vitormiran/flightscope-public/case/out/exploded.png

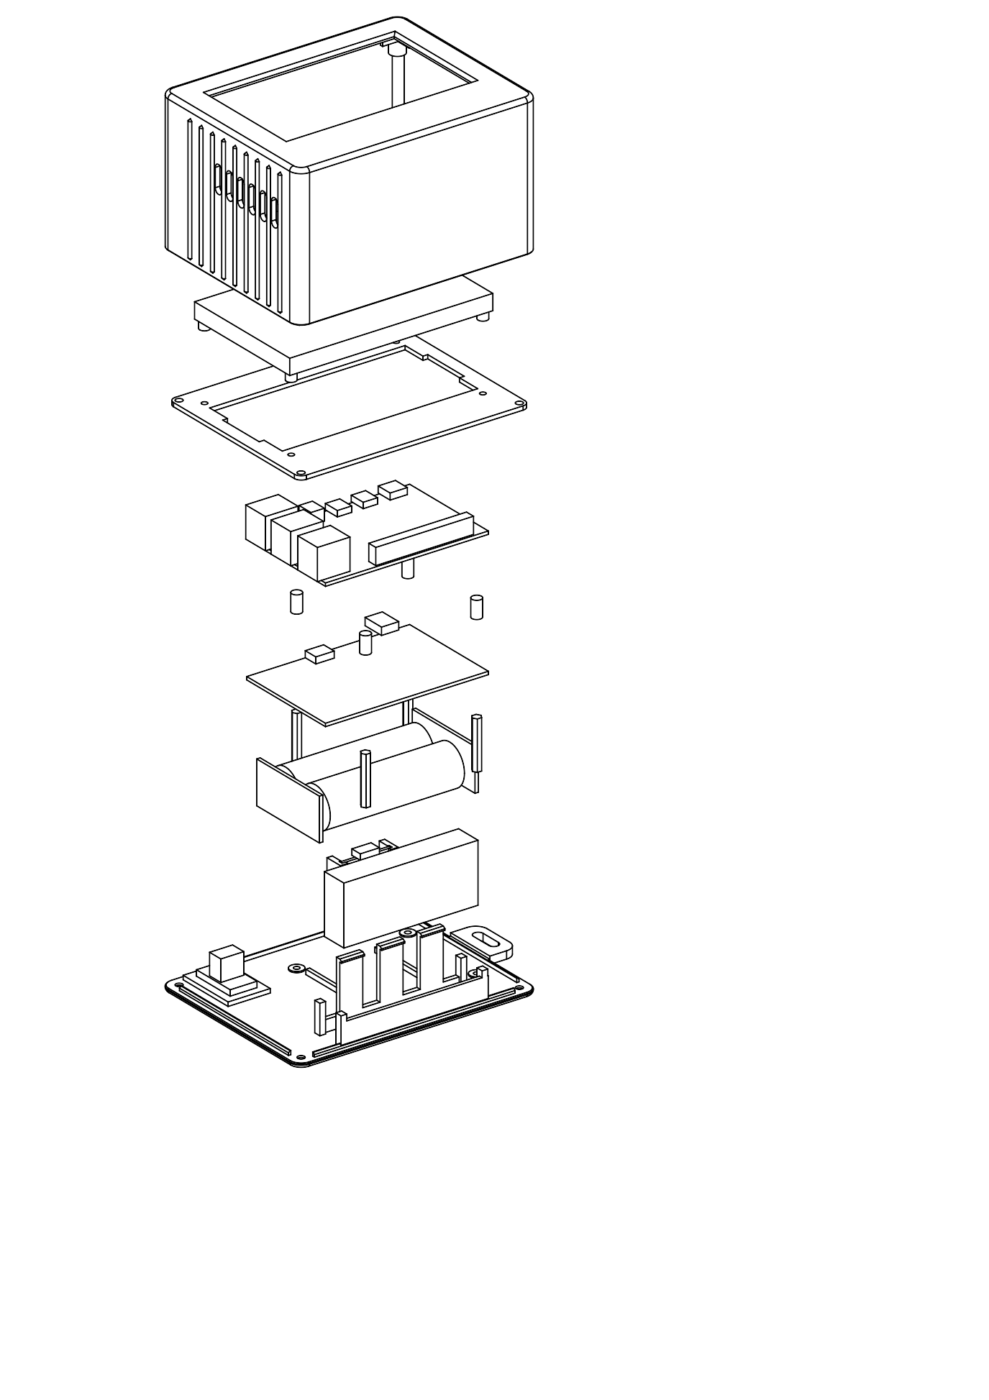
case/out/exploded.png
