vitormiran/flightscope-public/case/out/preview_front.png

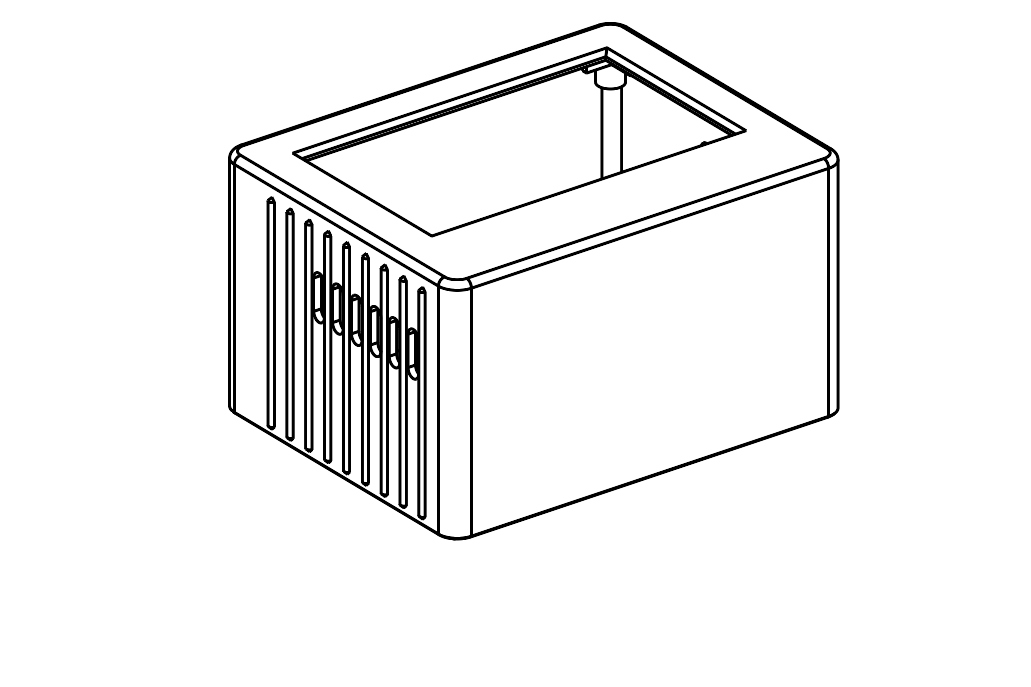
case/out/preview_front.png
