vitormiran/flightscope-public/case/out/preview_mid.png

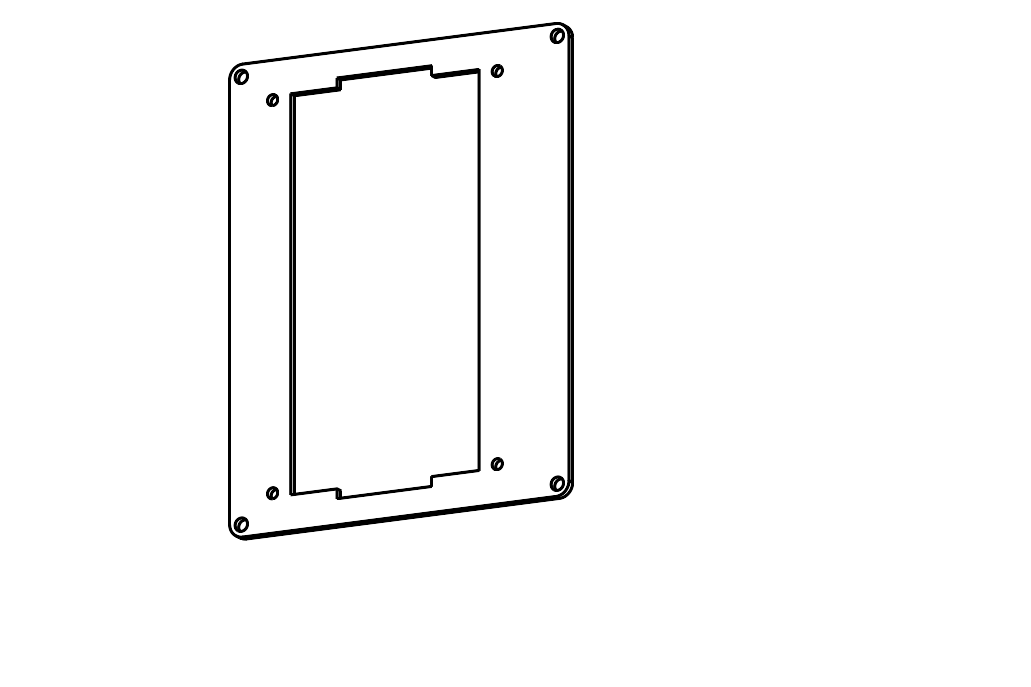
case/out/preview_mid.png
