vitormiran/flightscope-public/case/out/preview_rear.png

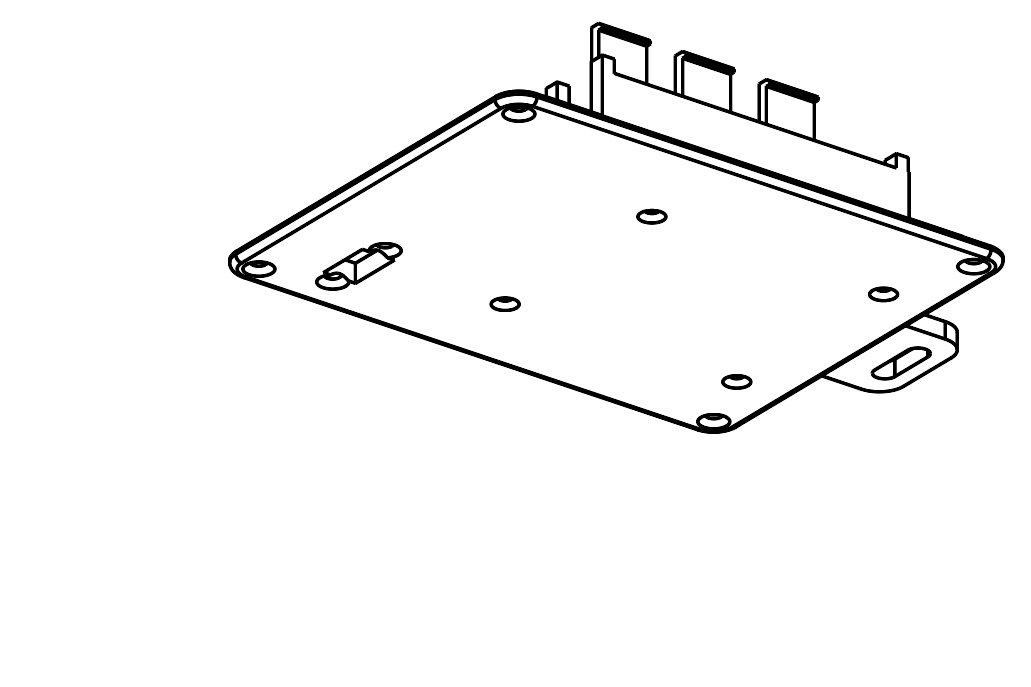
case/out/preview_rear.png
