vitormiran/flightscope-public/case/out/v7_cover_loaded.png

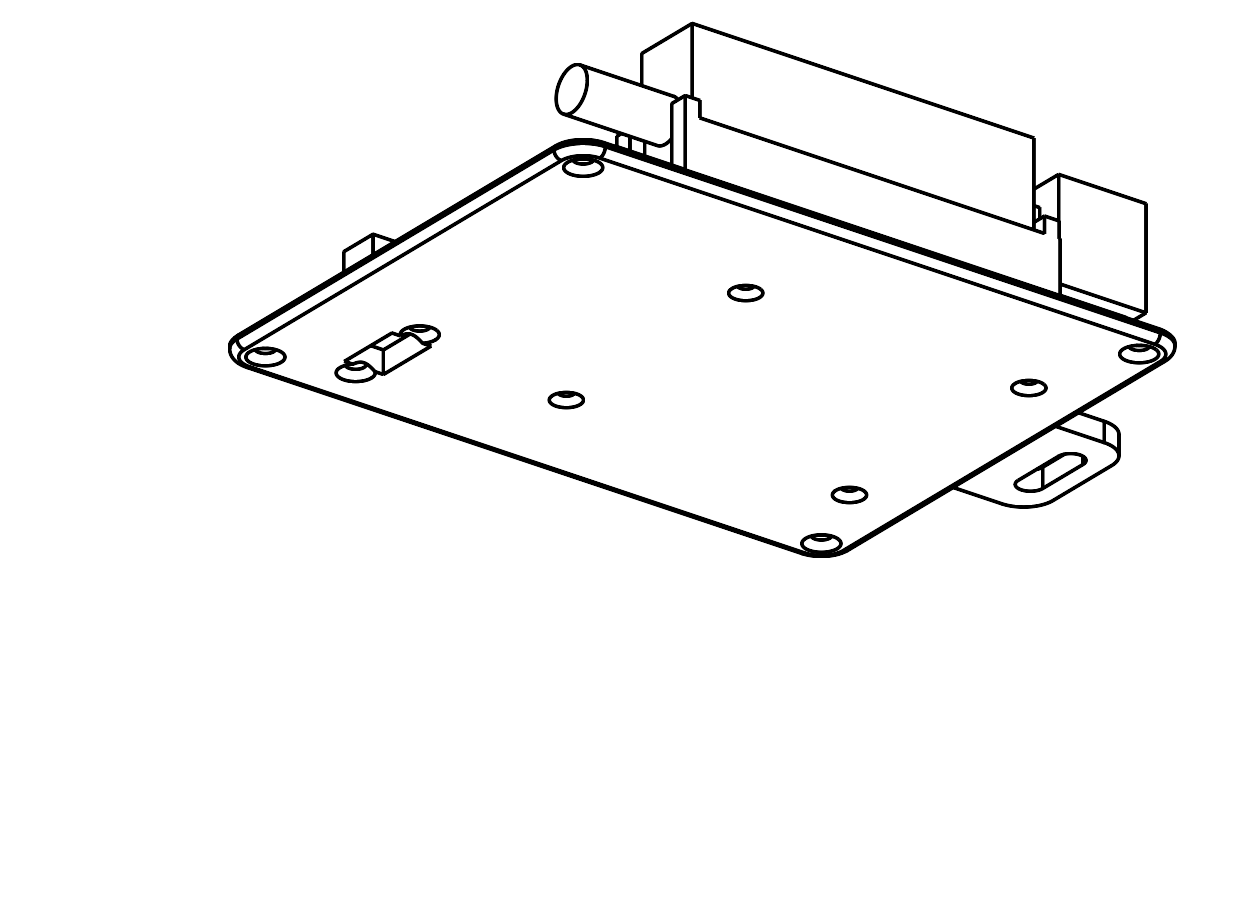
case/out/v7_cover_loaded.png
