vitormiran/flightscope-public/case/out/v7_cover_plan.png

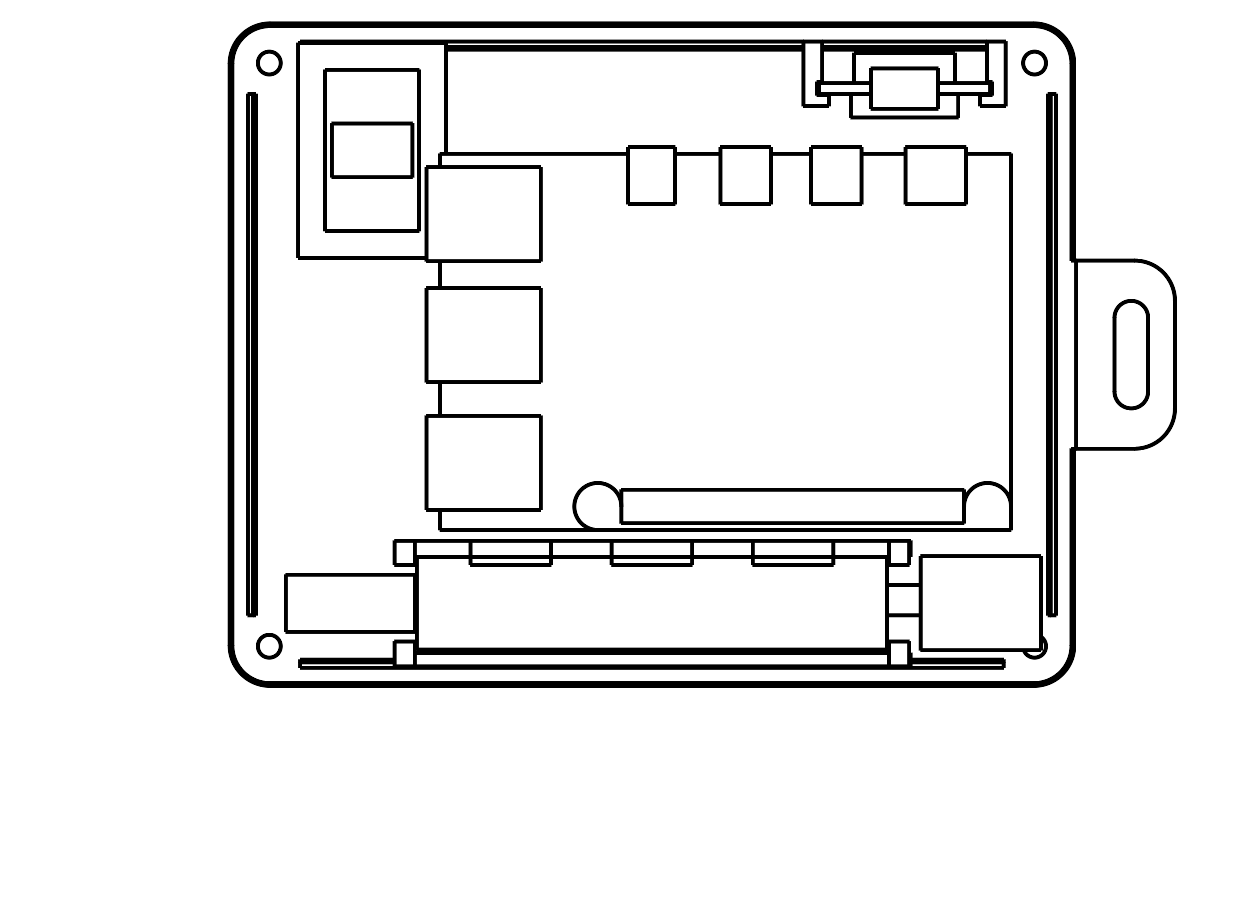
case/out/v7_cover_plan.png
