vitormiran/flightscope-public/case/out/v7_gps_back.png

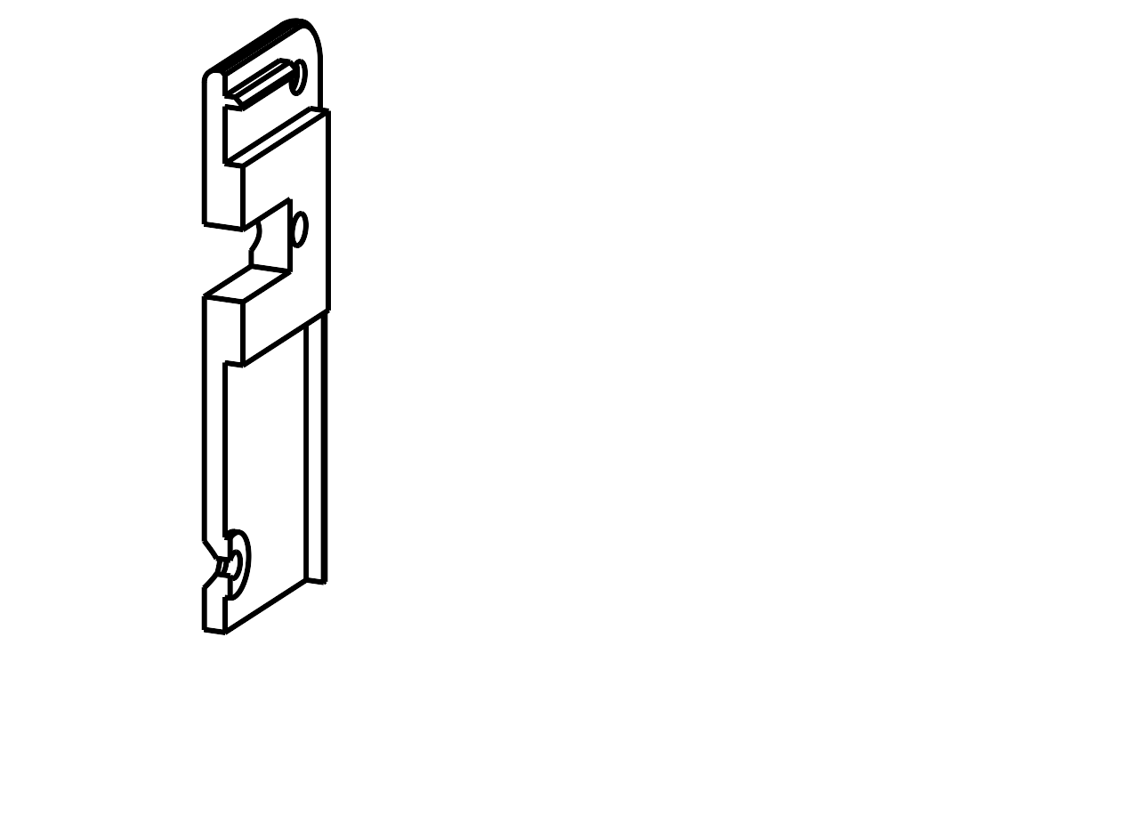
case/out/v7_gps_back.png
