vitormiran/flightscope-public/case/out/v7_gps_loaded.png

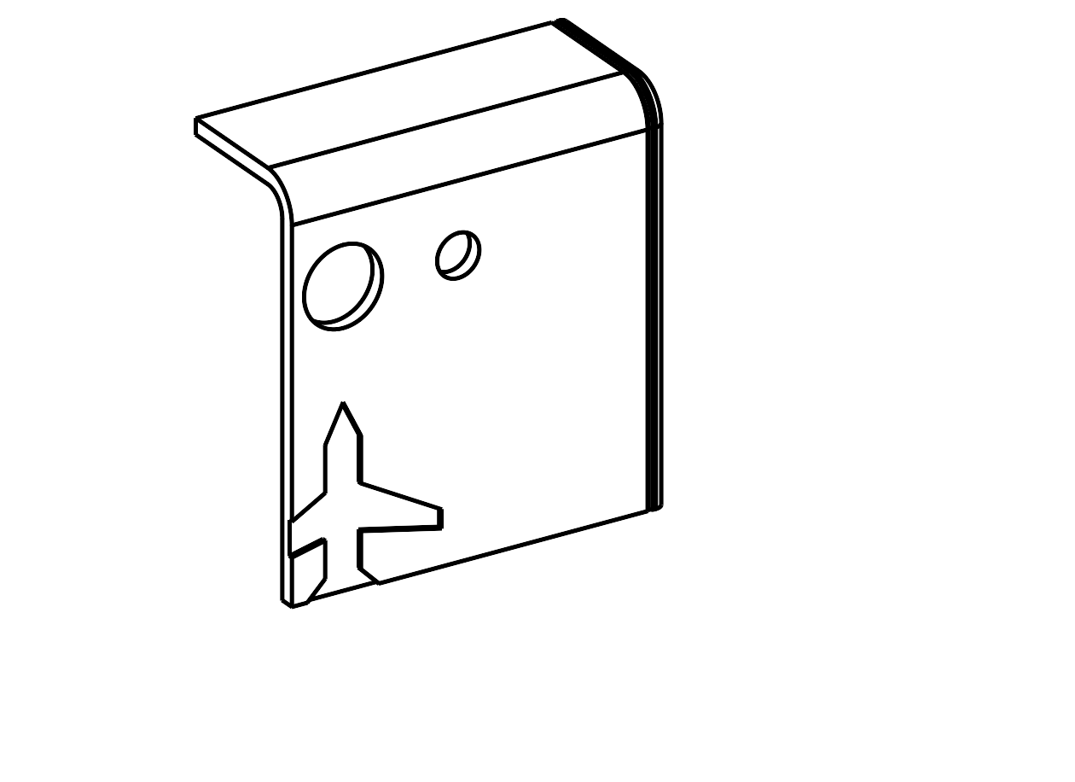
case/out/v7_gps_loaded.png
