vitormiran/flightscope-public/case/out/fit/mid_frame.stl

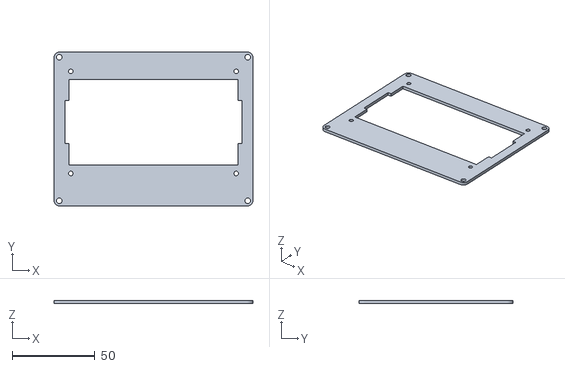
[picture p9: CAD file, 2026-11-12]
case/out/fit/mid_frame.stl
120.3 x 93.2 x 2.00
