vitormiran/flightscope-public/case/out/front_shell.stl

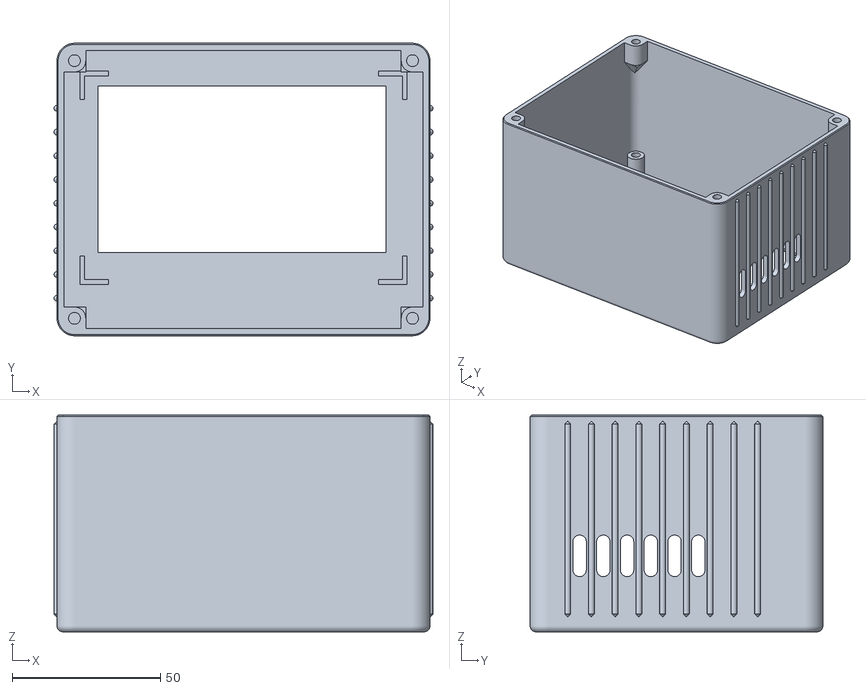
[picture p10: CAD file, 2026-11-12]
case/out/front_shell.stl
127.7 x 98.6 x 73.0
