vitormiran/flightscope-public/case/out/fit/usb_corner.stl

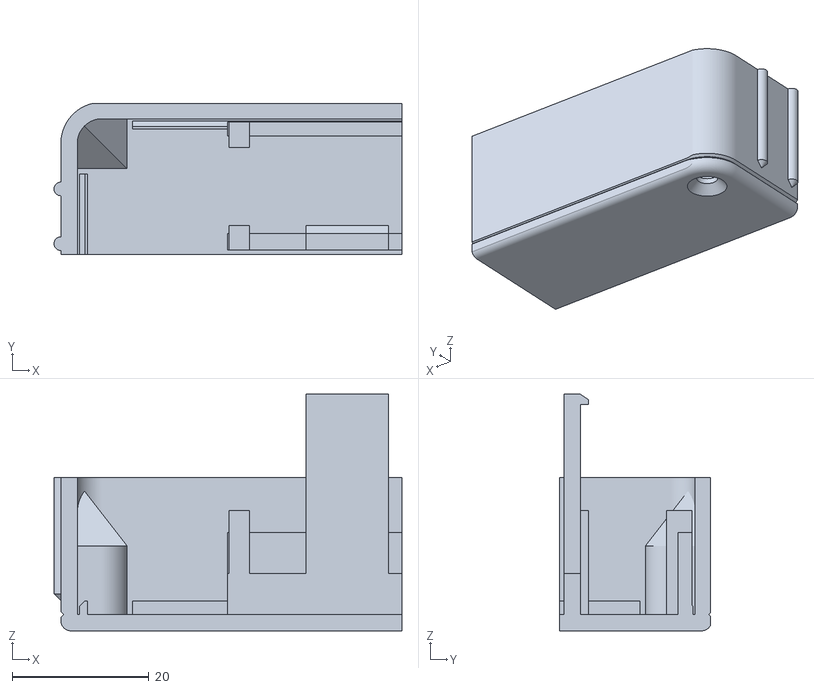
[picture p11: CAD file, 2026-11-12]
case/out/fit/usb_corner.stl
50.8 x 22.0 x 34.6
