vitormiran/flightscope-public/case/out/fit/rear_cover.stl

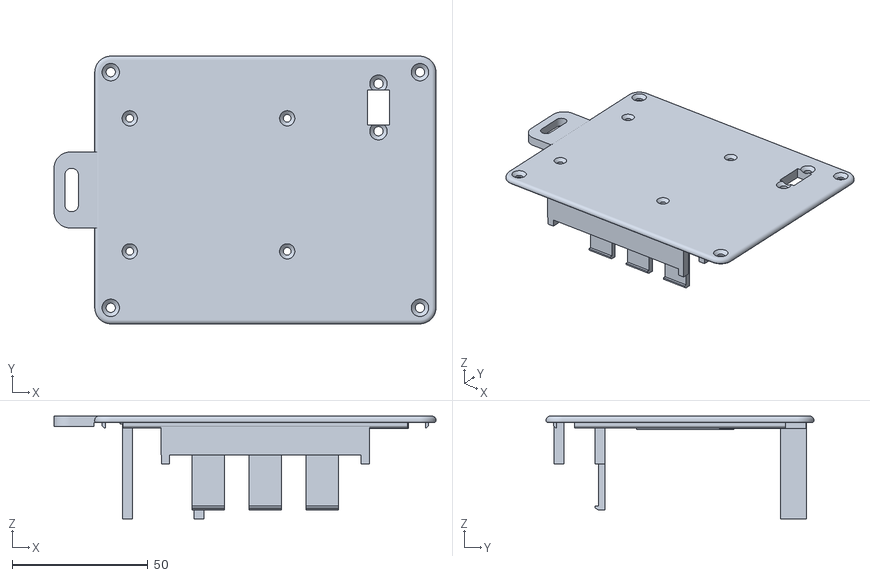
[picture p12: CAD file, 2026-11-12]
case/out/fit/rear_cover.stl
140.7 x 98.6 x 37.9
