vitormiran/flightscope-public/case/out/fit/bezel_tray.stl

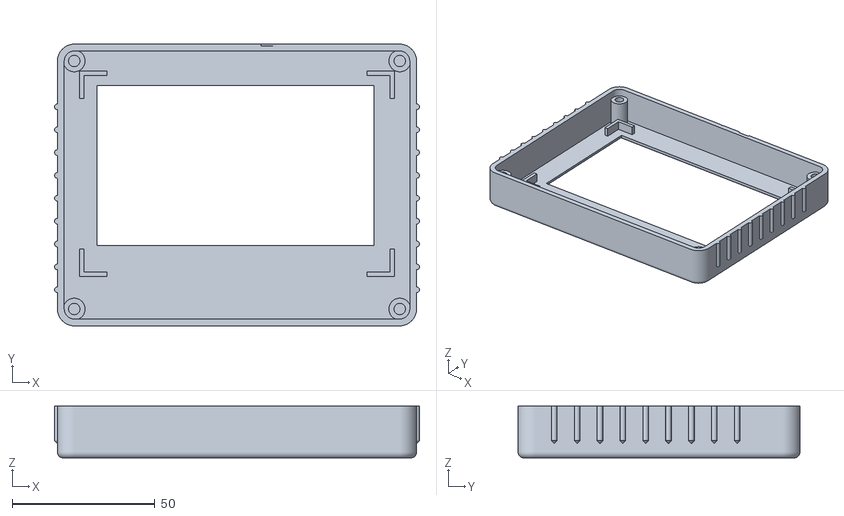
[picture p13: CAD file, 2026-11-12]
case/out/fit/bezel_tray.stl
127.7 x 98.6 x 18.1
