vitormiran/flightscope-public/case/out/fit/hole_coupon.stl

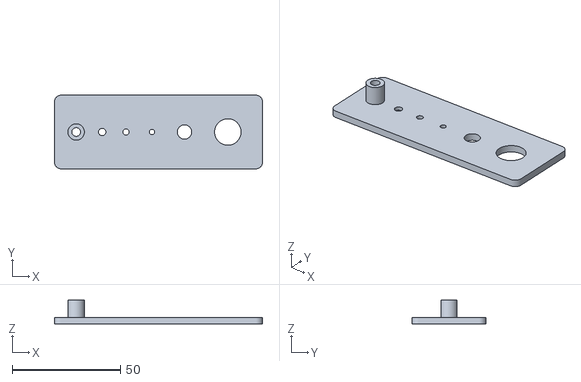
[picture p14: CAD file, 2026-11-12]
case/out/fit/hole_coupon.stl
96.0 x 34.0 x 11.0
