vitormiran/flightscope-public/(commit log)

2026-11-12 Case: engrave Daniel Tiger line art on the rear cover; add preview and tracing tools
    - flightscope_case.py: back_art() cuts imgs/daniel_polys.json 0.6 mm into the back face
    (ART_FILE, ART_H, ART_XY, ART_DEPTH). Engraved, not raised, because the back prints on the plate.
    - trace_image.py: turns a line-art PNG into the polygon JSON the model reads.
    - preview.py: live 3D preview in VS Code (OCP CAD Viewer) without writing STLs.
    - Rebuilt out/ and viewer_parts.js with build.sh (clashes: 0).
    - Add CLAUDE.md and IDEAS.md.
    [bezel_tray.stl, front_shell.stl, hole_coupon.stl, mid_frame.stl, rear_cover.stl, usb_corner.stl]
2026-11-12 Revert Daniel Tiger back engraving
    Removes back_art() and its constants from flightscope_case.py, the traced art and tracing tool,
    and restores the rebuilt out/ files and viewer_parts.js. Keeps CLAUDE.md, IDEAS.md and case/preview.py.
    [bezel_tray.stl, front_shell.stl, hole_coupon.stl, mid_frame.stl, rear_cover.stl, usb_corner.stl]
2026-11-12 Remove antenna and offline support; the device now requires Wi-Fi
    Drop the readsb source, DongleSleeper, the offline aircraft/route database
    and the "Antenna only" test switch. Routes come from adsbdb and adsb.im only.
    Remove the rtl-sdr package and DVB blacklist from provisioning, and update the
    docs. The bundled vector map is kept: it is drawing data, not a plane source.
2026-11-12 Revert "Remove antenna and offline support; the device now requires Wi-Fi"
    Offline support (readsb antenna, offline aircraft/route database, "Antenna
    only" test switch) is wanted again.
    This reverts commit 41a01e6.
    [app.py, config.py, offline.py, offlinedb.py]
